lilbudek/vkr/отчет/tex-report/README.txt

В данной директории находятся последнии отчёты и заключительное слово студента (текст доклада).
