lilbudek/vkr/отчет/tex/chapter-appendix-csae.tex

\appendix
\newpage
\addcontentsline{toc}{chapter}{Приложение}
\begin{flushright}
\uppercase{Приложение}\label{appendix}
\end{flushright}
\begin{code}
\captionof*{listing}{Программа генератора сигналов.}
\begin{minted}[mathescape,linenos,frame=lines,breaklines]{text}
#include <stdio.h>
#include <wchar.h>
#include <libopencm3/stm32/rcc.h>
#include <libopencm3/stm32/flash.h>
#include <libopencm3/stm32/gpio.h>
#include <libopencm3/stm32/timer.h>
#include <libopencm3/cm3/nvic.h>
#include <libopencm3/stm32/dac.h>
#include <libopencm3/stm32/i2c.h>
#include <ssd1306_i2c.h>

static void gpio_setup(void);   // установить входы/выходы
static void dac_setup(void);    // настройка цап
static void i2c_setup(void);    // настройка и2ц
static void timers_setup(void); // настройка таймеров
static void nvic_setup(void);   // настройка прерываний
void minus_freq(void);          //
void plus_freq(void);           //
void minus_signal(void);        // функции для кнопок
void plus_signal(void);         //
void step_select(void);         //

uint16_t p_acc = 0;         // аккумулятор фазы
int p_step = 0;             // код частоты 192 - 1khz
uint16_t step = 0;          // размер шага
uint16_t signal[256] = {0}; // буфер для цапа
int8_t num_sig = 0;         // номер сигнала
int8_t num_step = 0;        // номер шага

/*  отсчеты сигналов    */
uint16_t sinus[256] = {2048, 2092, 2136, 2180, 2224, 2268, 2312, 2355, 2399, 2442,
                       2485, 2527, 2570, 2612, 2654, 2695, 2736, 2777, 2817, 2857, 2896, 2934, 2973, 3010, 3047,
                       3084, 3119, 3155, 3189, 3223, 3256, 3288, 3320, 3351, 3381, 3410, 3439, 3466, 3493, 3519,
                       3544, 3568, 3591, 3613, 3635, 3655, 3674, 3693, 3710, 3726, 3742, 3756, 3770, 3782, 3793,
                       3803, 3812, 3821, 3828, 3833, 3838, 3842, 3845, 3846, 3847, 3846, 3845, 3842, 3838, 3833,
                       3828, 3821, 3812, 3803, 3793, 3782, 3770, 3756, 3742, 3726, 3710, 3693, 3674, 3655, 3635,
                       3613, 3591, 3568, 3544, 3519, 3493, 3466, 3439, 3410, 3381, 3351, 3320, 3288, 3256, 3223,
                       3189, 3155, 3119, 3084, 3047, 3010, 2973, 2934, 2896, 2857, 2817, 2777, 2736, 2695, 2654,
                       2612, 2570, 2527, 2485, 2442, 2399, 2355, 2312, 2268, 2224, 2180, 2136, 2092, 2048, 2003,
                       1959, 1915, 1871, 1827, 1783, 1740, 1696, 1653, 1610, 1568, 1525, 1483, 1441, 1400, 1359,
                       1318, 1278, 1238, 1199, 1161, 1122, 1085, 1048, 1011, 976, 940, 906, 872, 839, 807, 775,
                       744, 714, 685, 656, 629, 602, 576, 551, 527, 504, 482, 460, 440, 421, 402, 385, 369, 353,
                       339, 325, 313, 302, 292, 283, 274, 267, 262, 257, 253, 250, 249, 248, 249, 250, 253, 257,
                       262, 267, 274, 283, 292, 302, 313, 325, 339, 353, 369, 385, 402, 421, 440, 460, 482, 504,
                       527, 551, 576, 602, 629, 656, 685, 714, 744, 775, 807, 839, 872, 906, 940, 976, 1011, 1048,
                       1085, 1122, 1161, 1199, 1238, 1278, 1318, 1359, 1400, 1441, 1483, 1525, 1568, 1610, 1653,
                       1696, 1740, 1783, 1827, 1871, 1915, 1959, 2003};
/*                      */
uint16_t square[256] = {3847, 3847, 3847, 3847, 3847, 3847, 3847, 3847, 3847, 3847,
                        3847, 3847, 3847, 3847, 3847, 3847, 3847, 3847, 3847, 3847, 3847, 3847, 3847, 3847,
                        3847, 3847, 3847, 3847, 3847, 3847, 3847, 3847, 3847, 3847, 3847, 3847, 3847, 3847,
                        3847, 3847, 3847, 3847, 3847, 3847, 3847, 3847, 3847, 3847, 3847, 3847, 3847, 3847,
                        3847, 3847, 3847, 3847, 3847, 3847, 3847, 3847, 3847, 3847, 3847, 3847, 3847, 3847,
                        3847, 3847, 3847, 3847, 3847, 3847, 3847, 3847, 3847, 3847, 3847, 3847, 3847, 3847,
                        3847, 3847, 3847, 3847, 3847, 3847, 3847, 3847, 3847, 3847, 3847, 3847, 3847, 3847,
                        3847, 3847, 3847, 3847, 3847, 3847, 3847, 3847, 3847, 3847, 3847, 3847, 3847, 3847,
                        3847, 3847, 3847, 3847, 3847, 3847, 3847, 3847, 3847, 3847, 3847, 3847, 3847, 3847,
                        3847, 3847, 3847, 3847, 3847, 3847, 248, 248, 248, 248, 248, 248, 248, 248, 248, 248,
                        248, 248, 248, 248, 248, 248, 248, 248, 248, 248, 248, 248, 248, 248, 248, 248, 248,
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
}

int main(void)
{
    rcc_clock_setup_in_hse_8mhz_out_72mhz(); // установка тактирования
    gpio_setup();
    nvic_setup();
    dac_setup();
    timers_setup();
    i2c_setup();
    ssd1306_init(I2C2, DEFAULT_7bit_OLED_SLAVE_ADDRESS, 128, 64); // инициализация дисплея

    int f = 0;       // переменная частоты
    wchar_t freq[8]; // буфер для wchar_t строки
    while (1)
    {
        f = p_step / 24 * 125;
        swprintf(freq, sizeof(freq) / sizeof(wchar_t), L"%d", f); // Использование swprintf для преобразования int в wchar_t*
        /*  вывод информации на дисплей  */
        ssd1306_clear();
        ssd1306_drawWCharStr(0, 0, white, nowrap, L"Форма сигнала:");
        switch (num_sig)
        {
        case 1:
            ssd1306_drawWCharStr(0, 8, white, nowrap, L"Синус");
            break;
        case 2:
            ssd1306_drawWCharStr(0, 8, white, nowrap, L"Меандр");
            break;
        case 3:
            ssd1306_drawWCharStr(0, 8, white, nowrap, L"Треугольник");
            break;
        case 4:
            ssd1306_drawWCharStr(0, 8, white, nowrap, L"Пила Левая");
            break;
        case 5:
            ssd1306_drawWCharStr(0, 8, white, nowrap, L"Пила Правая");
            break;
        }
        ssd1306_drawWCharStr(0, 16, white, nowrap, L"Частота(Гц)");
        ssd1306_drawWCharStr(64, 16, white, nowrap, freq);
        ssd1306_drawWCharStr(0, 32, white, nowrap, L"Шаг(Гц)");
        switch (num_step)
        {
        case 1:
            ssd1306_drawWCharStr(64, 32, white, nowrap, L"125");
            break;
        case 2:
            ssd1306_drawWCharStr(64, 32, white, nowrap, L"250");
            break;
        case 3:
            ssd1306_drawWCharStr(64, 32, white, nowrap, L"500");
            break;
        case 4:
            ssd1306_drawWCharStr(64, 32, white, nowrap, L"1000");
            break;
        }
        ssd1306_refresh();
    }

    return 0;
}

static void gpio_setup(void)
{
    // rcc_periph_clock_enable(RCC_GPIOD); // тактирование портов
    rcc_periph_clock_enable(RCC_GPIOB);
    gpio_set_mode(GPIOB, GPIO_MODE_INPUT, GPIO_CNF_INPUT_PULL_UPDOWN, GPIO9 | GPIO5 | GPIO6 | GPIO7 | GPIO8); // входы для кнопок, подтянуты к земле
    // gpio_set_mode(GPIOD, GPIO_MODE_OUTPUT_50_MHZ, GPIO_CNF_OUTPUT_PUSHPULL, GPIO2);
}

static void dac_setup(void)
{
    rcc_periph_clock_enable(RCC_GPIOA);
    gpio_set_mode(GPIOA, GPIO_MODE_OUTPUT_2_MHZ, GPIO_CNF_OUTPUT_ALTFN_PUSHPULL, GPIO5);
    rcc_periph_clock_enable(RCC_DAC); // тактирование цапа и настройка вывода
    dac_enable(CHANNEL_2);            // включить цап
}

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

static void timers_setup(void)
{
    rcc_periph_clock_enable(RCC_TIM2);
    rcc_periph_clock_enable(RCC_TIM3);

    /* Стартовое значение таймера */
    TIM_CNT(TIM2) = 0;
    TIM_CNT(TIM3) = 0;

    /* Предделитель 36MHz/36000 => 1000 отсчетов в секунду (счет начинается с 0, поэтому в предделителе и периоде нужно отнимать единичку) */
    TIM_PSC(TIM2) = 17;
    TIM_PSC(TIM3) = 35999;

    /* Период таймера */
    TIM_ARR(TIM2) = 9;
    TIM_ARR(TIM3) = 249;

    /* Включить прерывания */
    TIM_DIER(TIM2) |= TIM_DIER_UIE;
    TIM_DIER(TIM3) |= TIM_DIER_UIE;

    /* Запустить таймер */
    TIM_CR1(TIM2) |= TIM_CR1_CEN;
    TIM_CR1(TIM3) |= TIM_CR1_CEN;
}

static void nvic_setup(void)
{
    /* Активировать прерывания и установить приоритеты */
    nvic_enable_irq(NVIC_TIM2_IRQ);
    nvic_set_priority(NVIC_TIM2_IRQ, 2);

    nvic_enable_irq(NVIC_TIM3_IRQ);
    nvic_set_priority(NVIC_TIM3_IRQ, 1);
}

void minus_freq(void)
{
    bool cur_val = 0;
    bool prev_val = 0;
    cur_val = gpio_get(GPIOB, GPIO5);
    if (cur_val == 1 && prev_val == 0)
    {
        p_step -= step;
    }
    if (p_step < 0) // ограничение 0
    {
        p_step = 0;
    }
    prev_val = cur_val;
}

void plus_freq(void)
{
    bool cur_val = 0;
    bool prev_val = 0;
    cur_val = gpio_get(GPIOB, GPIO6);
    if (cur_val == 1 && prev_val == 0)
    {
        p_step += step;
    }
    if (p_step > 9600) // ограничение 50 кГц
    {
        p_step = 9600;
    }
    prev_val = cur_val;
}

void minus_signal(void)
{
    bool cur_val = 0;
    bool prev_val = 0;
    cur_val = gpio_get(GPIOB, GPIO7);
    if (cur_val == 1 && prev_val == 0)
    {
        dac_disable(CHANNEL_2);
        num_sig -= 1;
        if (num_sig < 1)
            num_sig = 1;
        switch (num_sig)
        {
        case 1:
            for (int i = 0; i < 256; i++)
                signal[i] = sinus[i];
            break;
        case 2:
            for (int i = 0; i < 256; i++)
                signal[i] = square[i];
            break;
        case 3:
            for (int i = 0; i < 256; i++)
                signal[i] = triangle[i];
            break;
        case 4:
            for (int i = 0; i < 256; i++)
                signal[i] = l_saw[i];
            break;
        case 5:
            for (int i = 0; i < 256; i++)
                signal[i] = r_saw[i];
            break;
        }
        dac_enable(CHANNEL_2);
    }
    prev_val = cur_val;
}

void plus_signal(void)
{
    bool cur_val = 0;
    bool prev_val = 0;
    cur_val = gpio_get(GPIOB, GPIO8);
    if (cur_val == 1 && prev_val == 0)
    {
        dac_disable(CHANNEL_2);
        num_sig += 1;
        switch (num_sig)
        {
        case 1:
            for (int i = 0; i < 256; i++)
                signal[i] = sinus[i];
            break;
        case 2:
            for (int i = 0; i < 256; i++)
                signal[i] = square[i];
            break;
        case 3:
            for (int i = 0; i < 256; i++)
                signal[i] = triangle[i];
            break;
        case 4:
            for (int i = 0; i < 256; i++)
                signal[i] = l_saw[i];
            break;
        case 5:
            for (int i = 0; i < 256; i++)
                signal[i] = r_saw[i];
            break;
        }
        if (num_sig > 5)
            num_sig = 5;
        dac_enable(CHANNEL_2);
    }
    prev_val = cur_val;
}

void step_select(void)
{
    bool cur_val = 0;
    bool prev_val = 0;
    cur_val = gpio_get(GPIOB, GPIO9);
    if (cur_val == 1 && prev_val == 0)
    {
        num_step += 1;
        switch (num_step)
        {
        case 1:
            step = 24; // 125 Гц
            break;
        case 2:
            step = 48; // 250 Гц
            break;
        case 3:
            step = 96; // 500 Гц
            break;
        case 4:
            step = 192; // 1000 Гц
            break;
        case 5:
            step = 24; // 125 Гц
            num_step = 1;
            break;
        }
    }
}
\end{minted}
\end{code}

% Проверить работу в содержании, правильную нумерацию приложений и переброску по ссылки.
%\chapter*{Приложение A}
%\phantomsection
%\addcontentsline{toc}{chapter}{Приложение A}
%\label{appendixA}
