lilbudek/vkr/отчет/tex-presentation/pictures/struct_gen.pdf

Кнопки | Микроконтроллер

Дисплей

I2C

Выход ЦАП
