lilbudek/vkr/отчет/image/README.txt

В данной директории должны находится все рисунки, которые используются в ВКР.
