lilbudek/vkr/отчет/tex-presentation/README.txt

В данной директории должны находится файлы относящиеся к презентации.
