lilbudek/vkr/отчет/tex/README.txt

В данной директории находятся файлы ВКР, то есть основной работы.
