lilbudek/vkr/отчет/tex-presentation/pres.pdf

## Программный генератор сигналов на основе микроконтроллера STM32

Студент гр. 506: Вебер Данил Сергеевич Руководитель: ст.пр. Уланов Пётр Николаевич

Алтайский государственный университет

2024

## Актуальность

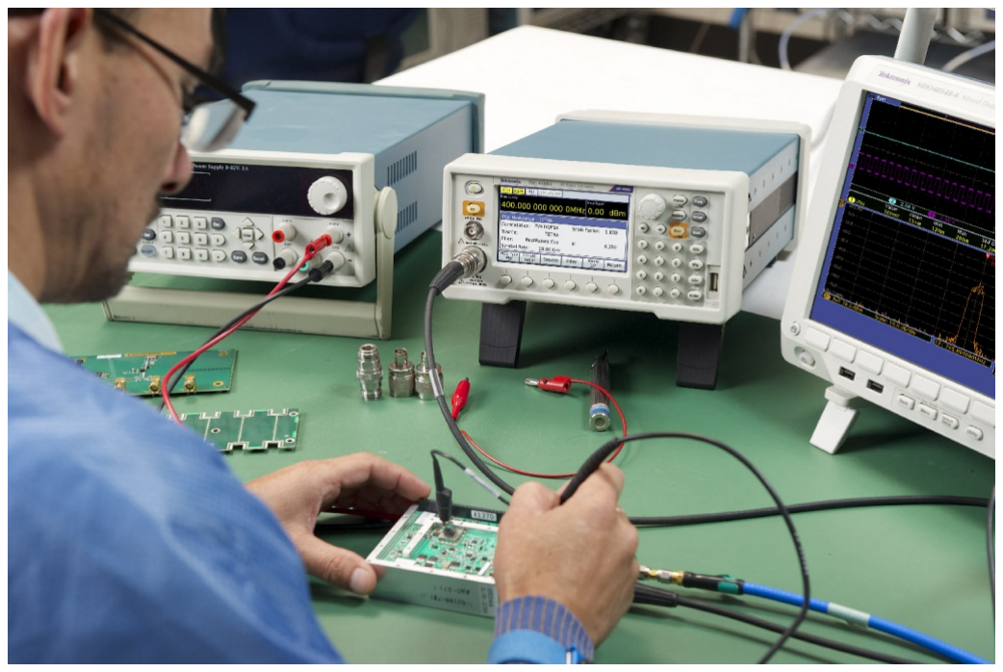
[picture p51: figure]

Тестирование и отладка устройства.

## Цель и задачи

Цель: разработка программного генератора сигналов на микроконтроллере.
Задачи:
1 | Исследовать методы генерации сигналов и осуществить выбор;
2 | Рассмотреть семейства микроконтроллеров и осуществить выбор;
3 | Выбрать среду разработки;
4 | Разработать программу;
5 | Спроектировать устройство;
6 | Протестировать генератор.

## Методы цифровой генерации сигнала

1 | Метод аппроксимации. +: Малый объем памяти, так как хранятся только параметры сигнала. —: Высокие вычислительные затраты, что ограничивает максимальную частоту сигнала.
2 | CORDIC. +: Быстродействие и высокая точность системы, благодаря итерационному методу. —: Сложность алгоритма и потребность в специализированных вычислениях.
3 | Табличный метод. +: Возможность генерации сигналов с более высокой частотой из-за отсутствия вычислений. —: Необходимость хранения больших объёмов данных в памяти.
4 | Метод DDS. +: Гибкость, простота реализации и высокая точность регулирования частоты. —: Потребность в дополнительных вычислениях для генерации сигнала.

## Метод DDS

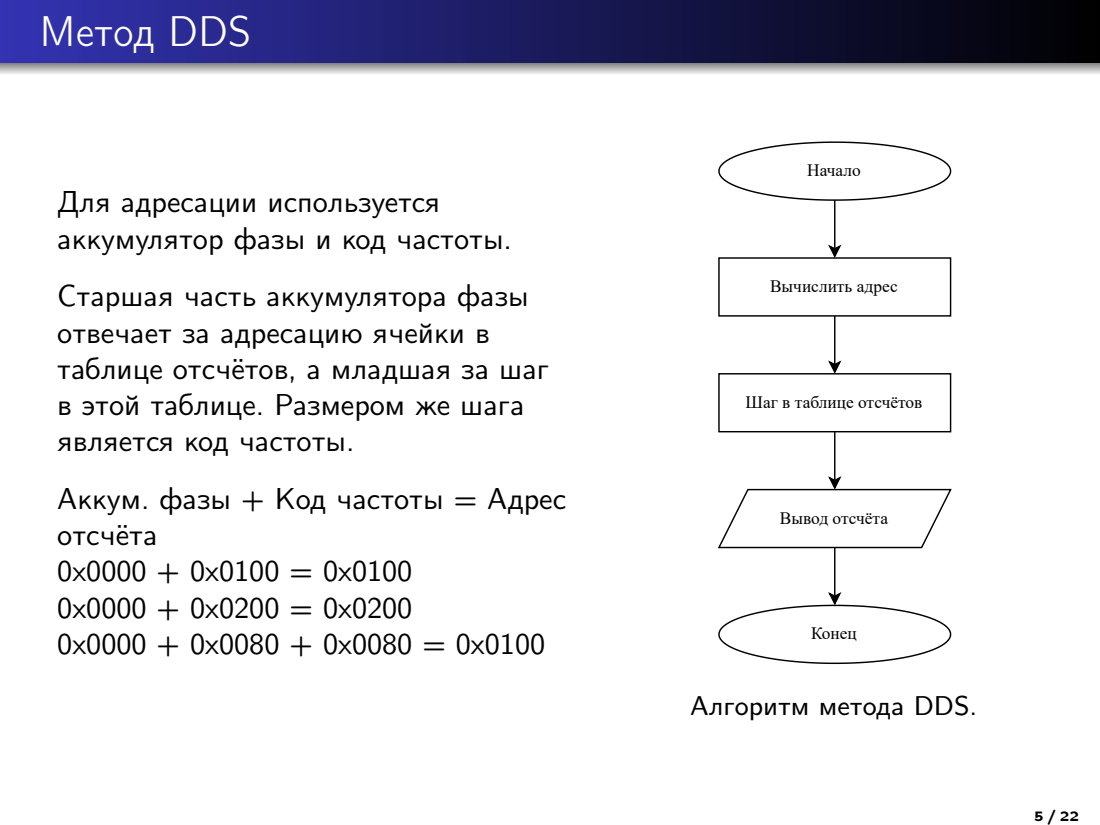
[picture p52: page 5]
Аккум. фазы + Код частоты = Адрес отсчёта 0x0000 + 0x0100 = 0x0100 0x0000 + 0x0200 = 0x0200 0x0000 + 0x0080 + 0x0080 = 0x0100; Начало; Вычислить адрес; Вывод отсчёта; Конец

Для адресации используется
аккумулятор фазы и код частоты.

Старшая часть аккумулятора фазы
отвечает за адресацию ячейки в
таблице отсчётов, а младшая за шаг
в этой таблице. Размером же шага
является код частоты.

Шаг в таблице отсчётов

Алгоритм метода DDS.

## Существующие генераторы

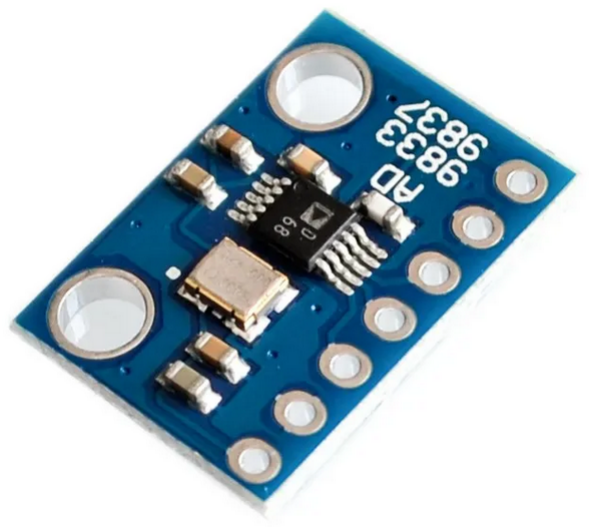
[picture p53: figure]

Модуль AD9833. | АКТАКОМ AWG-4112.

+: компактность, возможность
интеграции с другими
компонентами.
—: необходимость в управляющем устройстве.

+: высокая точность, широкий диапазон частот.
—: большие размеры, высокая стоимость.

## Микроконтроллеры

Параметры микроконтроллеров

Параметр | ATtiny10 | ATmega32 | STM32L010F4 | STM32F103xC
Частота | 20 МГц | 20 МГц | 32 МГц | 72 МГц
FLASH | 1 Кбайт | 32 Кбайт | 16 Кбайт | 256 Кбайт
RAM | 64 байт | 2 Кбайт | 2 Кбайт | 48 Кбайт
SPI | - | + | + | +
I2C | - | + | + | +
Питание | 1,8 — 5,5 В | 1,8 — 5,5 В | 1,8 — 3,6 В | 1,8 — 3,6 В

## Выбор микроконтроллера и среды разработки

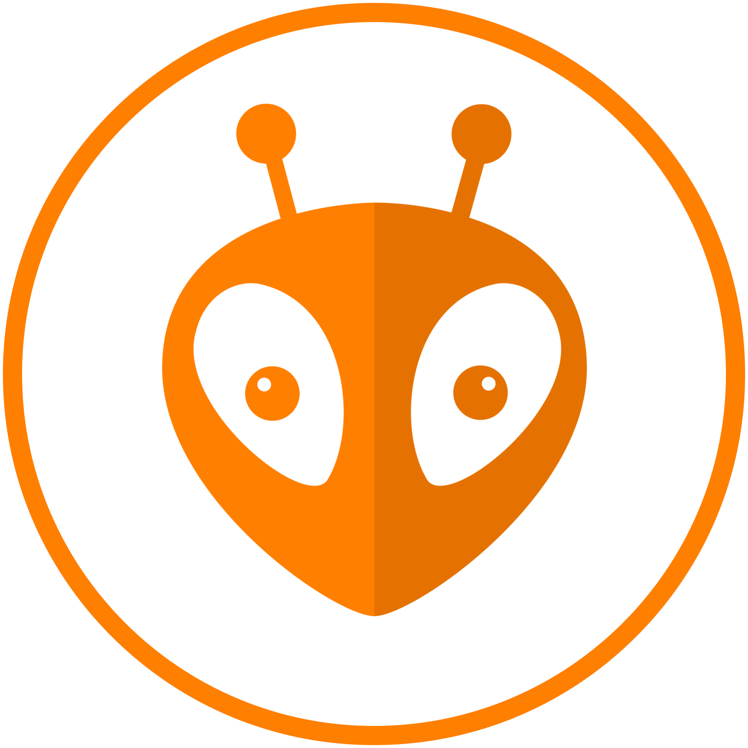
[picture p54: figure]
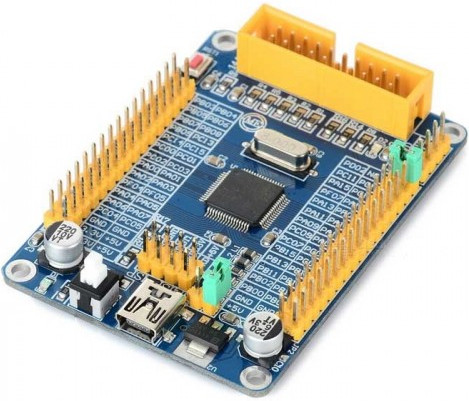
[picture p55: figure]

Микроконтроллер | IDE

Микроконтроллер: STM32F103RCT6 на отладочной плате. Среда разработки: VSCode + PlatformIO.
Язык программирования: C.
Библиотека: libopencm3.

## Программа для генерации сигналов

Кнопки | Микроконтроллер

Дисплей

I2C

Выход ЦАП

Структурная схема генератора сигналов.

Программа должна выполнять три действия:
1 | Вывод отсчёта в ЦАП;
2 | Обработка кнопок;
3 | Вывод информации на дисплей.

## Программа для генерации сигналов

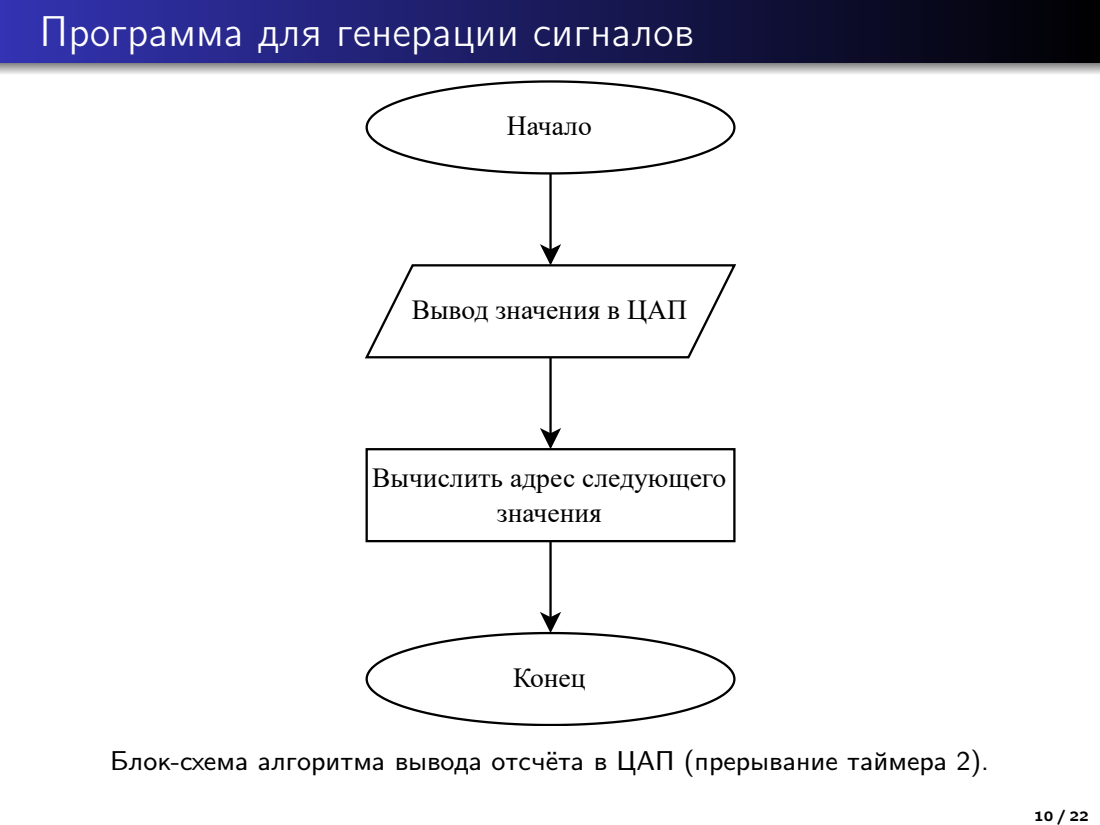
[picture p56: page 10]
Начало; значения; Конец

Вывод значения в ЦАП

Вычислить адрес следующего

Блок-схема алгоритма вывода отсчёта в ЦАП (прерывание таймера 2).

## Программа для генерации сигналов

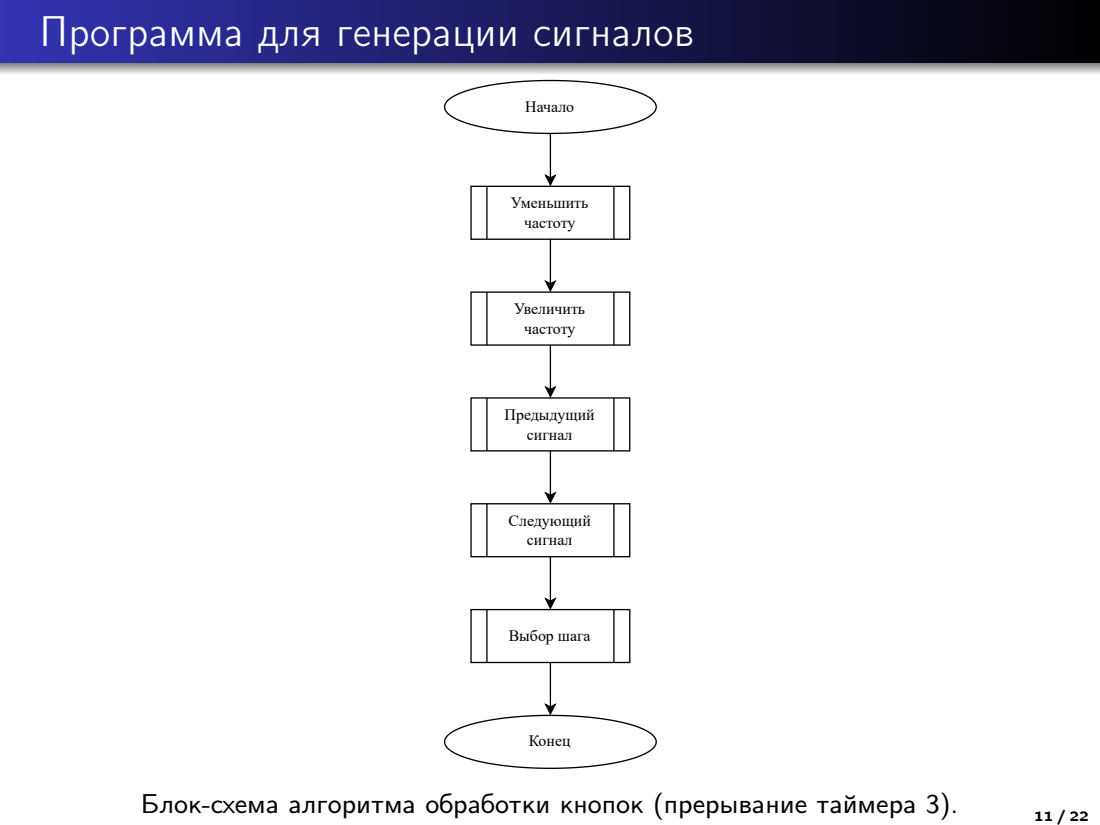
[picture p57: page 11]
Начало; Уменьшить частоту; Увеличить частоту; Предыдущий сигнал; Следующий сигнал; Выбор шага; Конец; Блок-схема алгоритма обработки кнопок (прерывание таймера 3).

## Программа для генерации сигналов

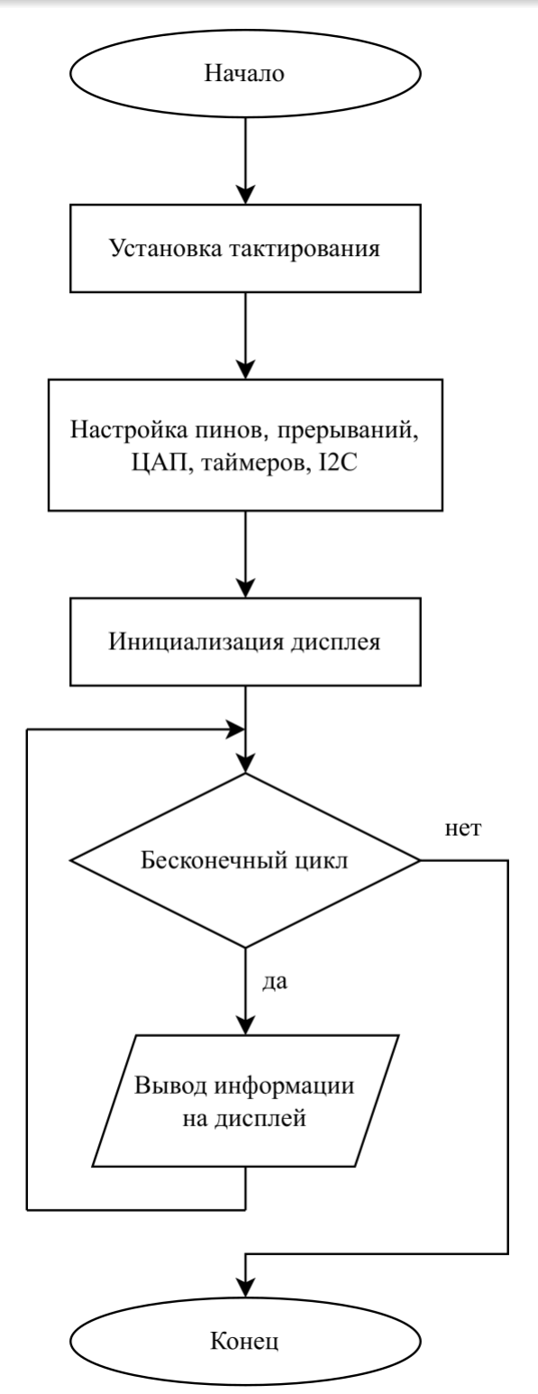
[picture p58: figure]

Блок-схема алгоритма главной функции. | 12 / 22

## Проектирование генератора сигналов

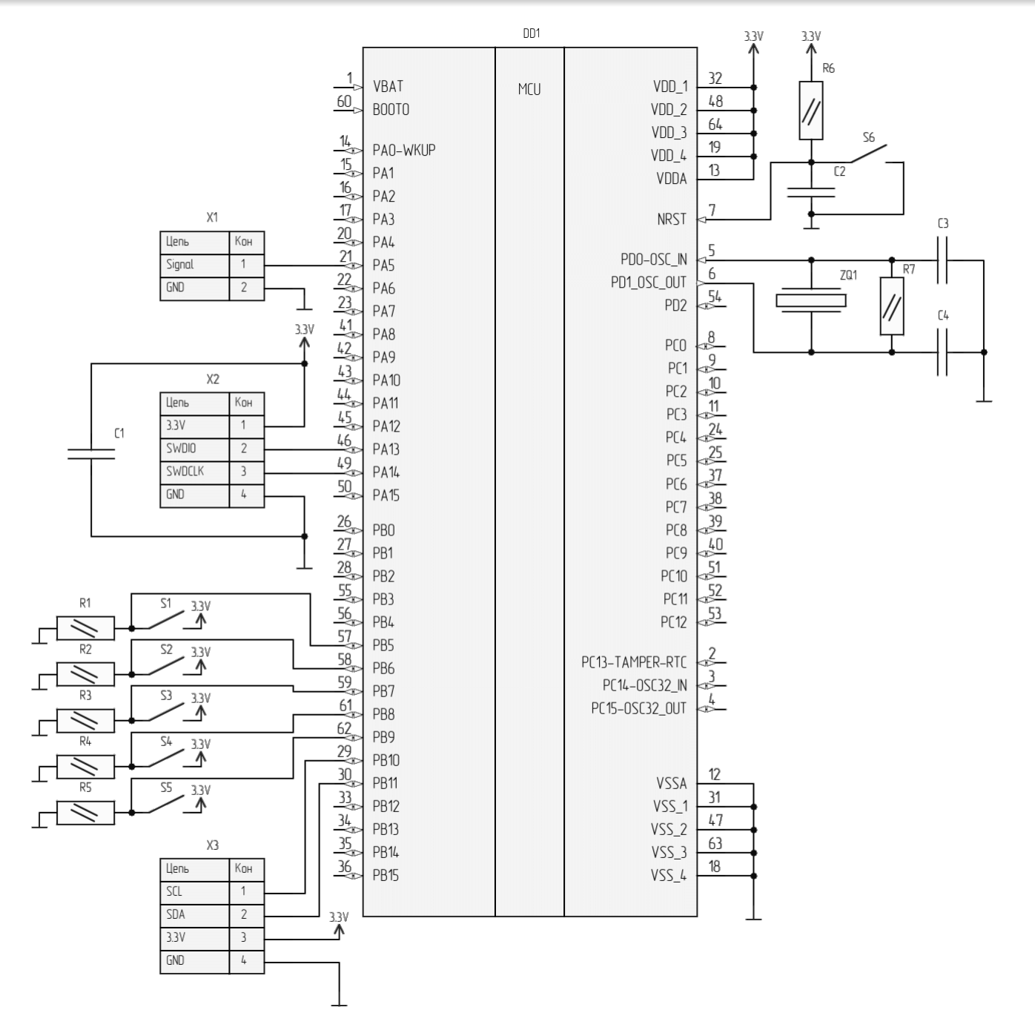
[picture p59: figure]

Фрагмент схемы электрической принципиальной. | 13 / 22

## Проектирование генератора сигналов

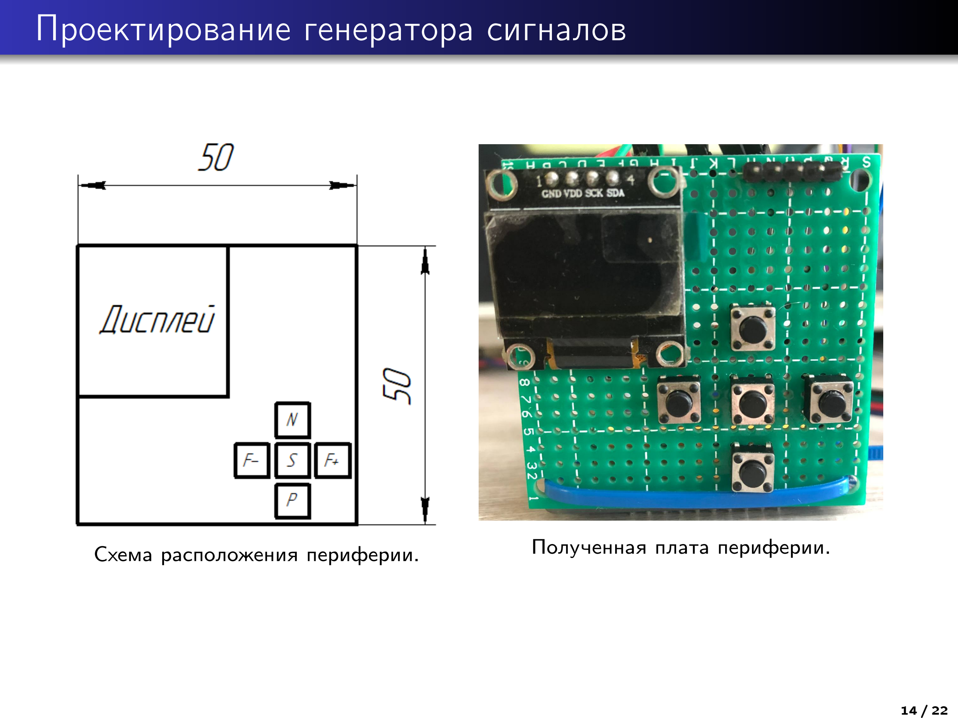
[picture p60: page 14]

Схема расположения периферии. | Полученная плата периферии.

## Проектирование генератора сигналов

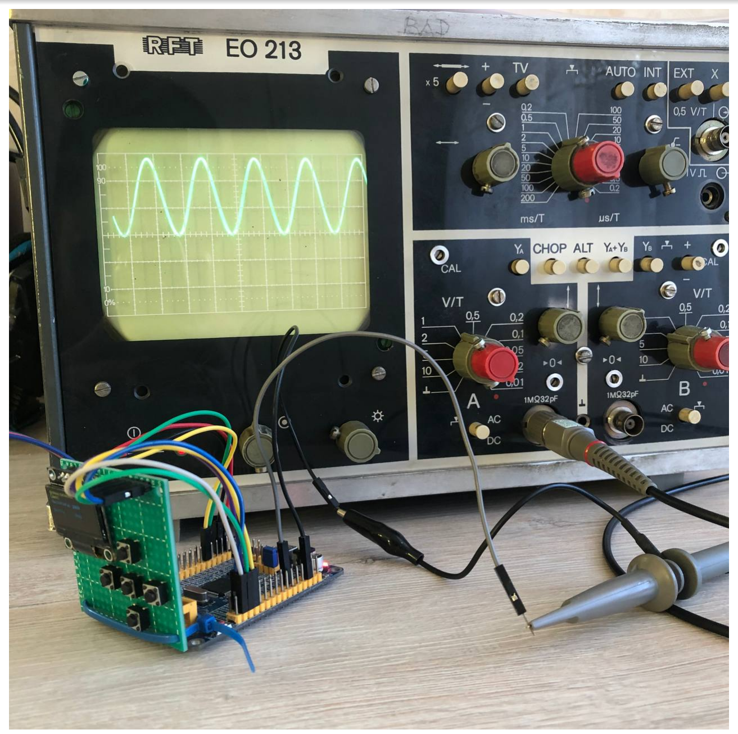
[picture p61: figure]

Макет устройства. | 15 / 22

## Тестирование

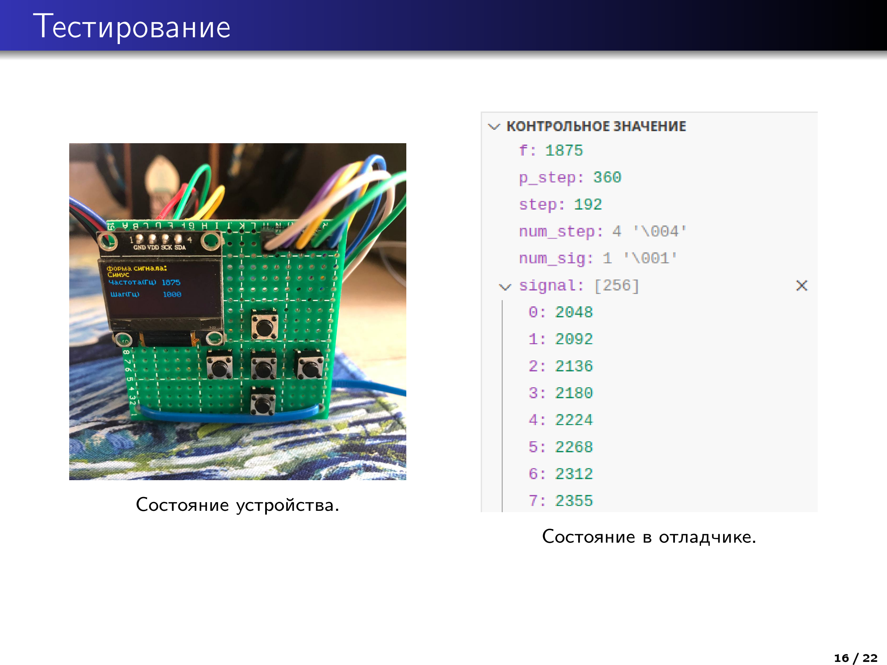
[picture p62: page 16]

Состояние устройства.

Состояние в отладчике.

## Тестирование

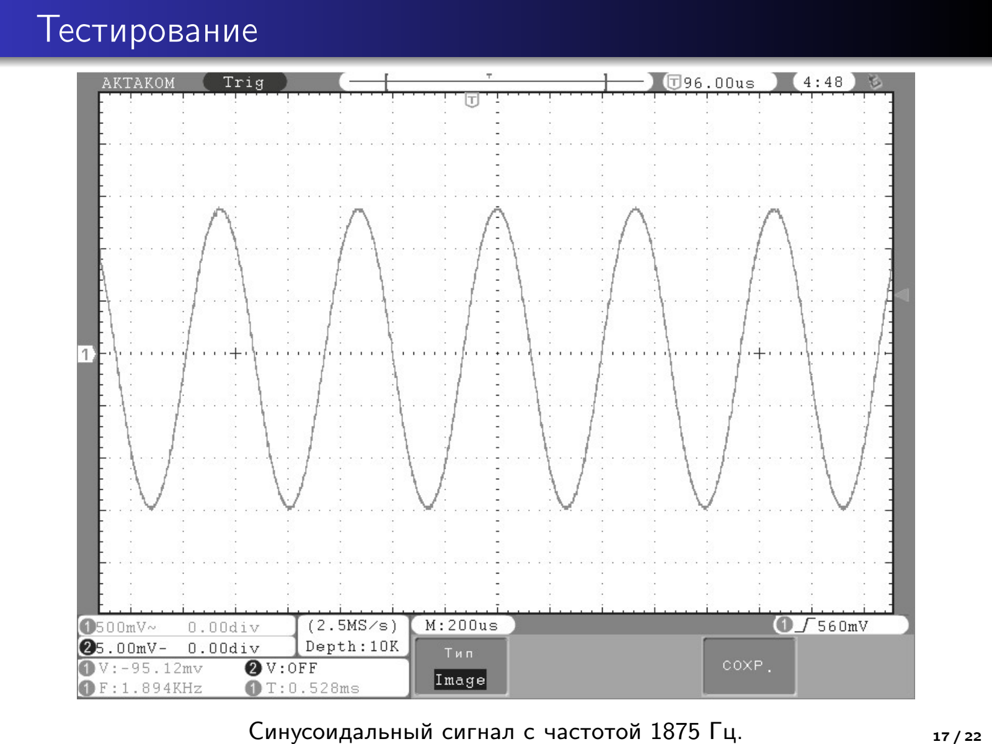
[picture p63: page 17]

Синусоидальный сигнал с частотой 1875 Гц. | 17 / 22

## Тестирование

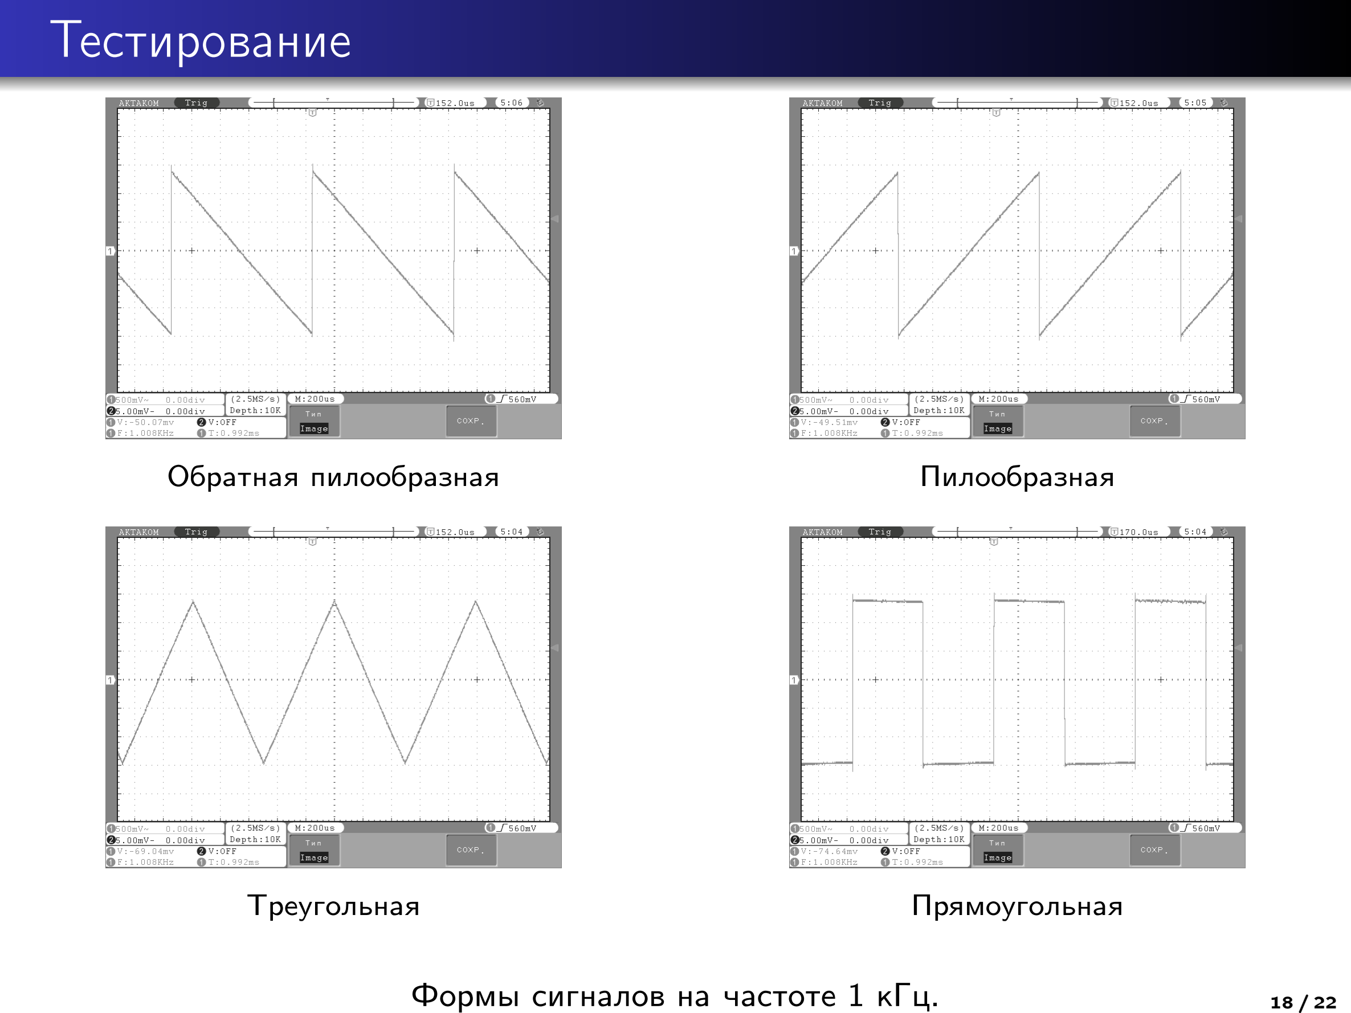
[picture p64: page 18]

Обратная пилообразная | Пилообразная
Треугольная | Прямоугольная
Формы сигналов на частоте 1 кГц. | 18 / 22

## Тестирование

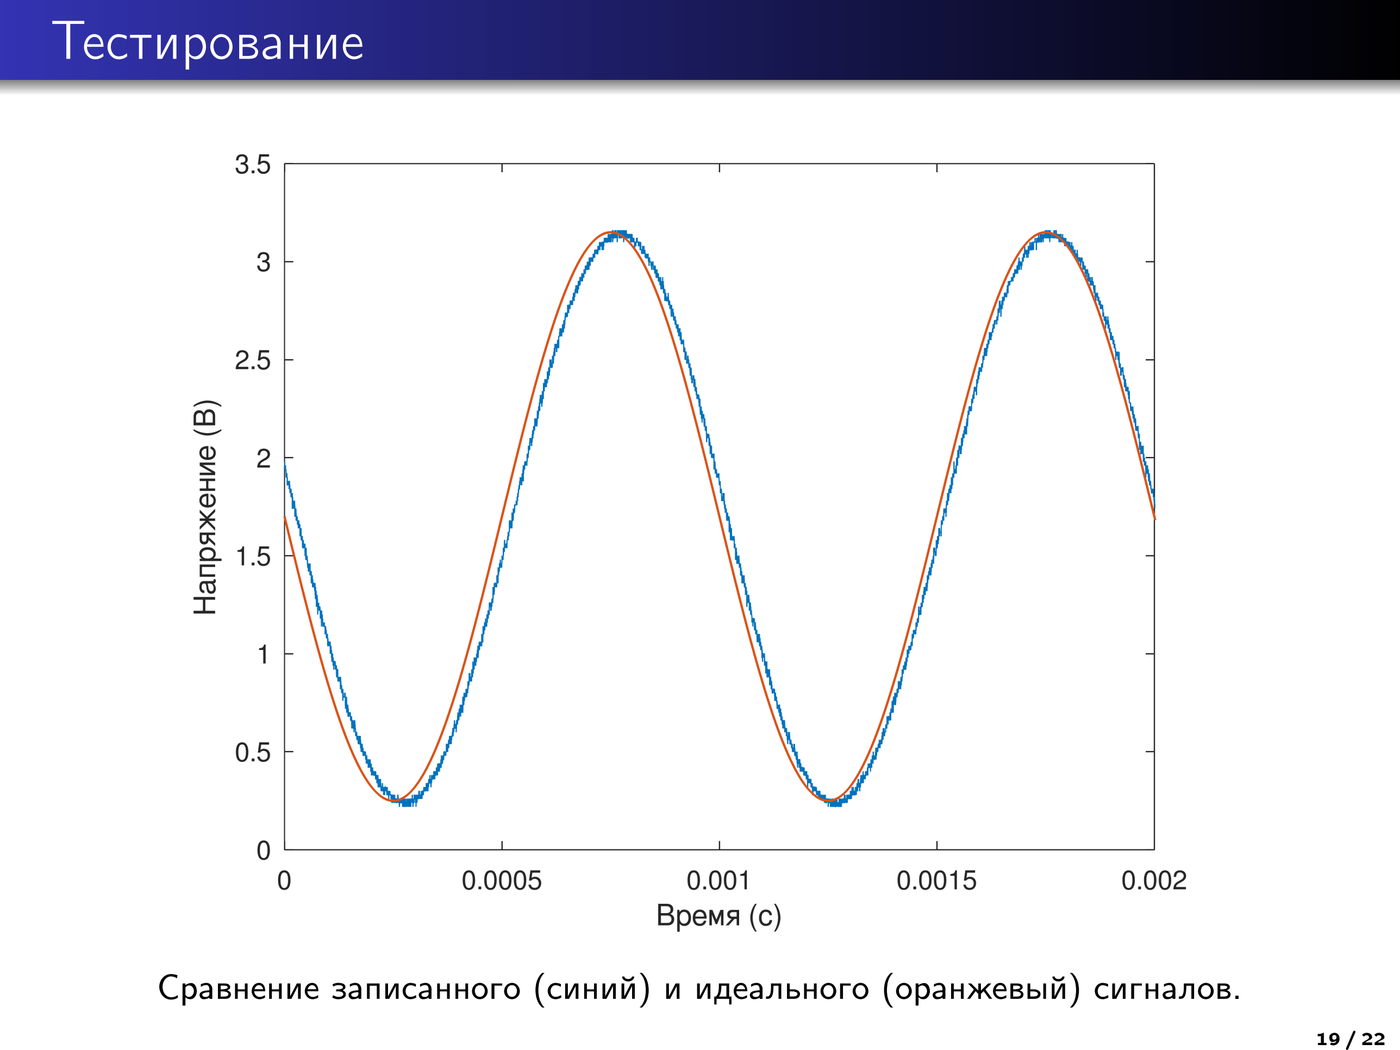
[picture p65: page 19]

Сравнение записанного (синий) и идеального (оранжевый) сигналов.

## Тестирование

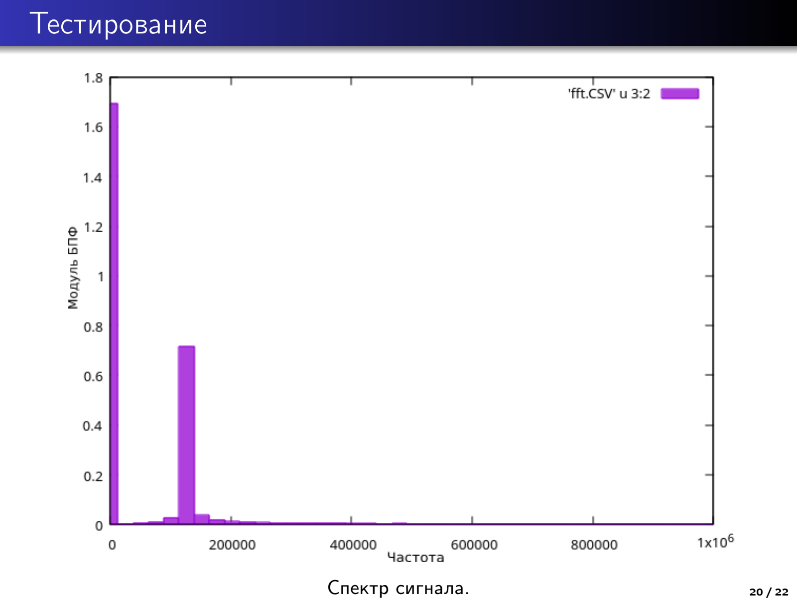
[picture p66: page 20]

Спектр сигнала. | 20 / 22

## Заключение

В ходе выполнения работы цель была достигнута: разработан программный генератор сигналов на микроконтроллере STM32F103RCT6, позволяющий генерировать сигналы разной формы со следующими характеристиками:
Формы сигналов: синус, треугольник, прямоугольник, пилообразная, обратная пилообразная.
Частота сигнала: 125 — 50000 Гц.
Шаг по частоте: 125, 250, 500, 1000 Гц.
Были выполнены все поставленные задачи, а именно:
1 | Выбран метод генерации сигналов;
2 | Выбран микроконтроллер;
3 | Выбрана среда разработки;
4 | Разработана программа;
5 | Спроектировано устройство;
6 | Протестирован генератор.

# Спасибо за внимание!
