lilbudek/vkr/отчет/image/scheme-cropped.pdf

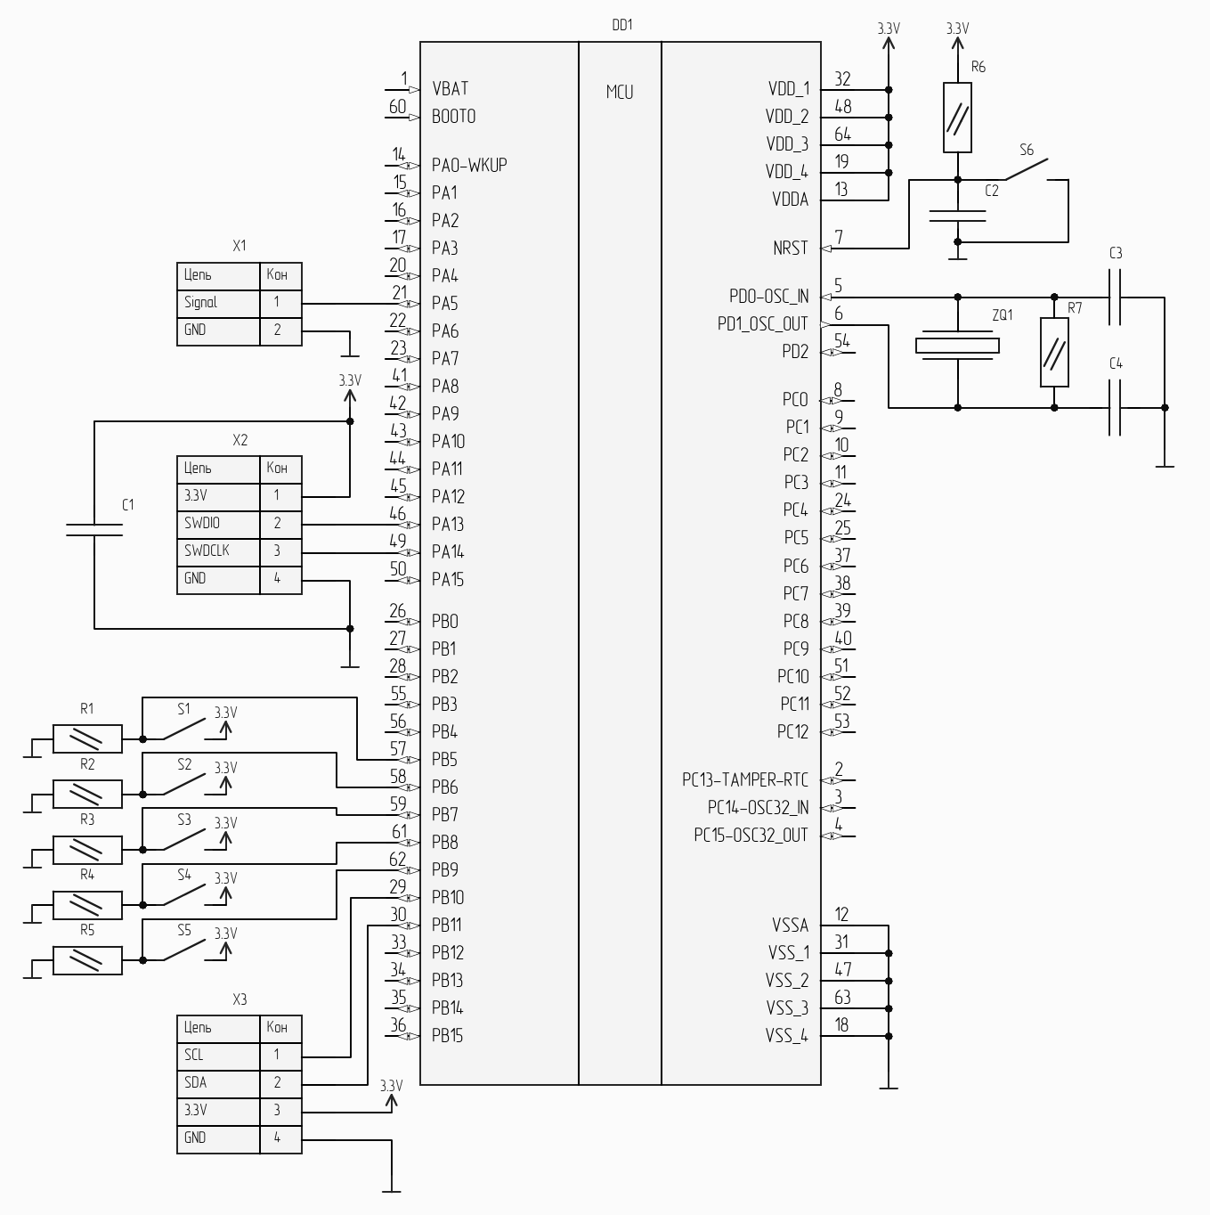
[picture p67: page 1]
