lilbudek/vkr/моя наука/pictures/qr-code.pdf

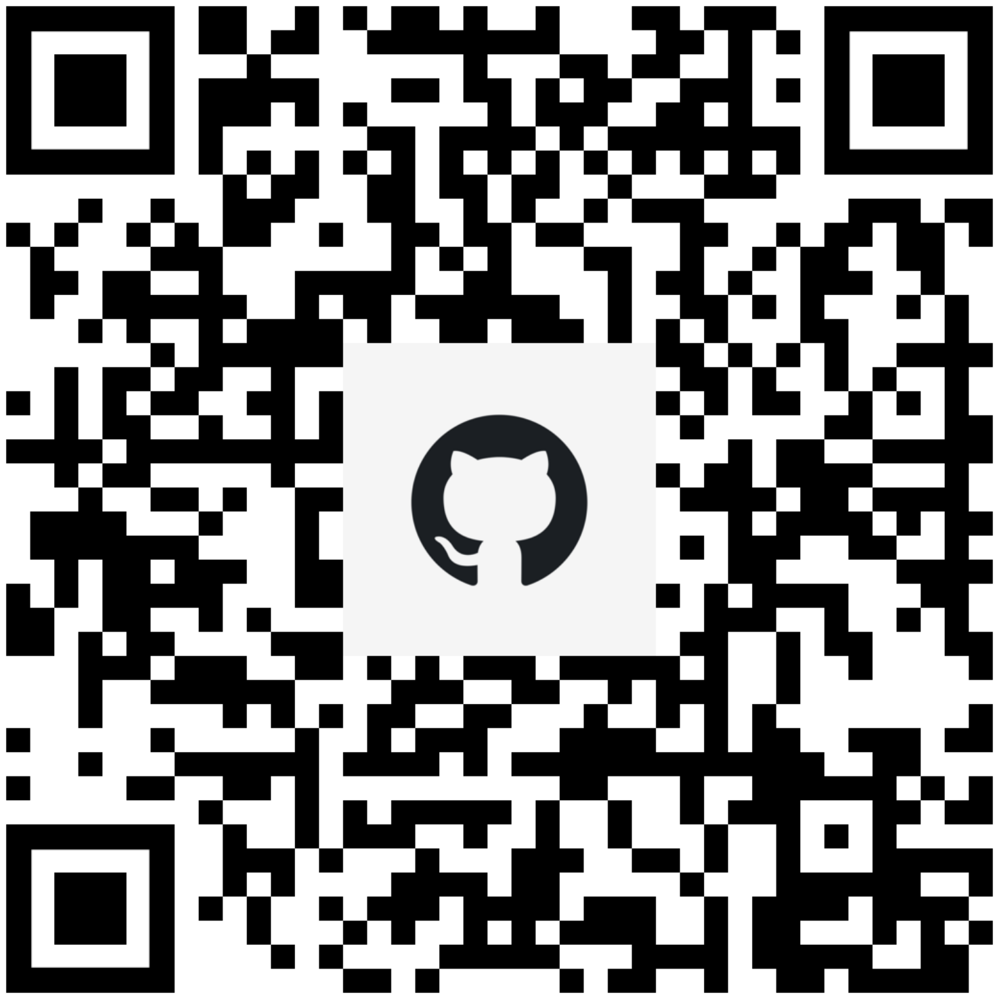
[picture p68: page 1]
