lilbudek/vkr/отчет/tex-presentation/pictures/main.pdf

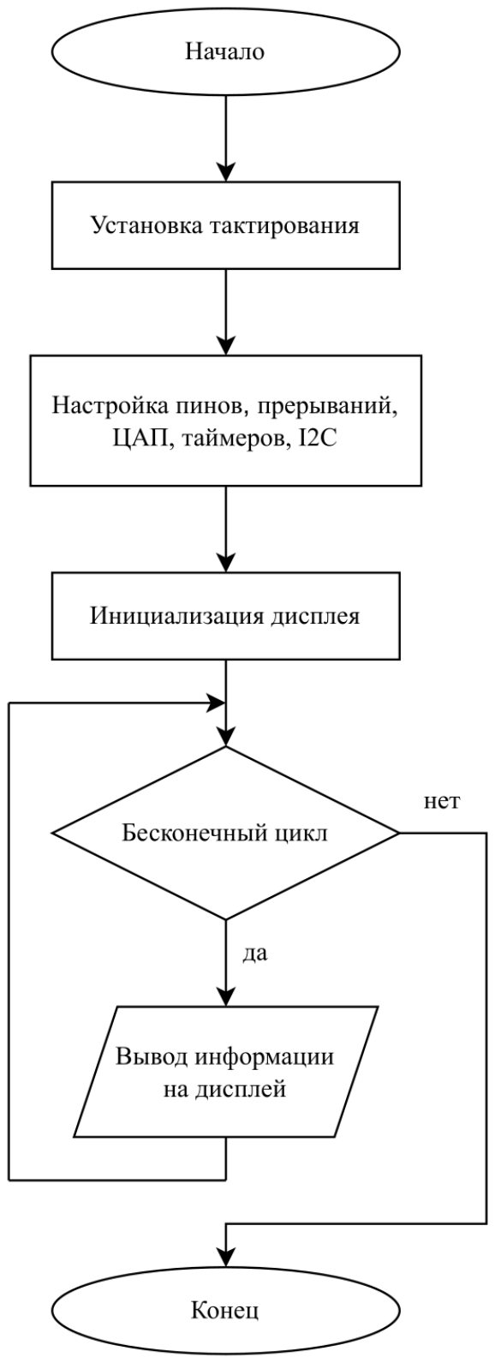
[picture p69: page 1]
