lilbudek/vkr/защита темы/pres.pdf

## Создание программного генератора сигналов

разной формы на микроконтроллере STM32.

Студент гр. 506: Вебер Д.С. Научный руководитель: ст.пр. Уланов П.Н.

Алтайский государственный университет

2023

## Цель и задачи

Цель работы: разработка программы для генерации сигналов на микроконтроллере STM32.
Задачи:
1 | Исследовать существующие способы программной генерации сигналов.
2 | Выбрать микроконтроллер для реализации.
3 | Выбрать среду разработки.
4 | Написать программу.
5 | Провести проверку работоспособности.

## Микроконтроллеры

МК Параметр | F103RCT6 | F302CBT6 | F373CCT6 | G431CBT6
Память программ | 256 Кбайт | 128 Кбайт | 256 Кбайт | 128 Кбайт
ОЗУ | 48 Кбайт | 32 Кбайт | 32 Кбайт | 32 Кбайт
Тактовая частота | 72 МГц | 72 МГц | 72 МГц | 170 МГц
Кол-во вх/вых | 51 | 37 | 36 | 38
ЦАП | 2х12б | 1х12б | 3х12б | 4х12б
