lilbudek/vkr/отчет/image/125.bmp

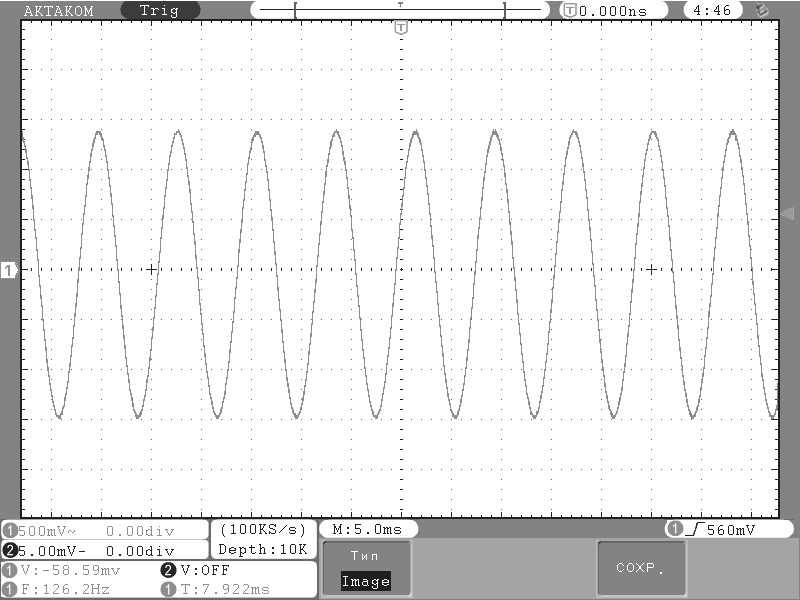
отчет/image/125.bmp
