lilbudek/vkr/отчет/image/875.bmp

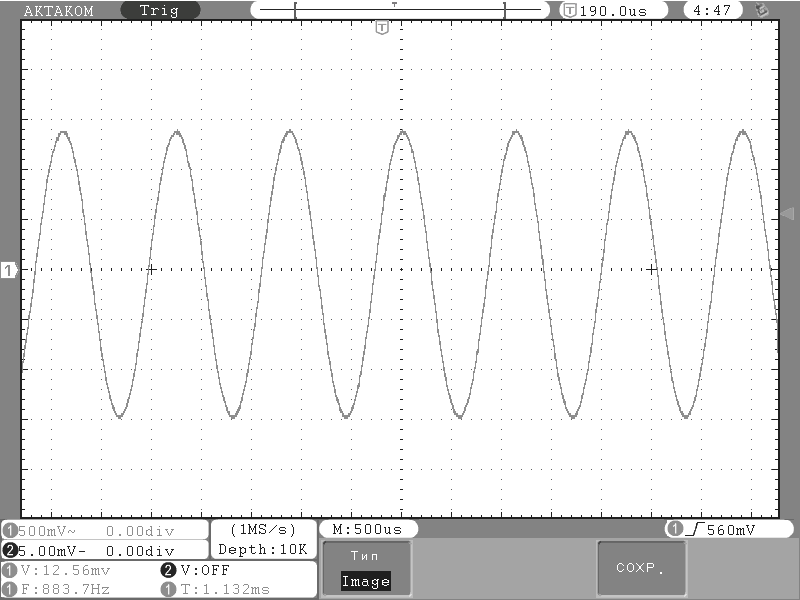
отчет/image/875.bmp
