lilbudek/vkr/отчет/image/l_saw10.bmp

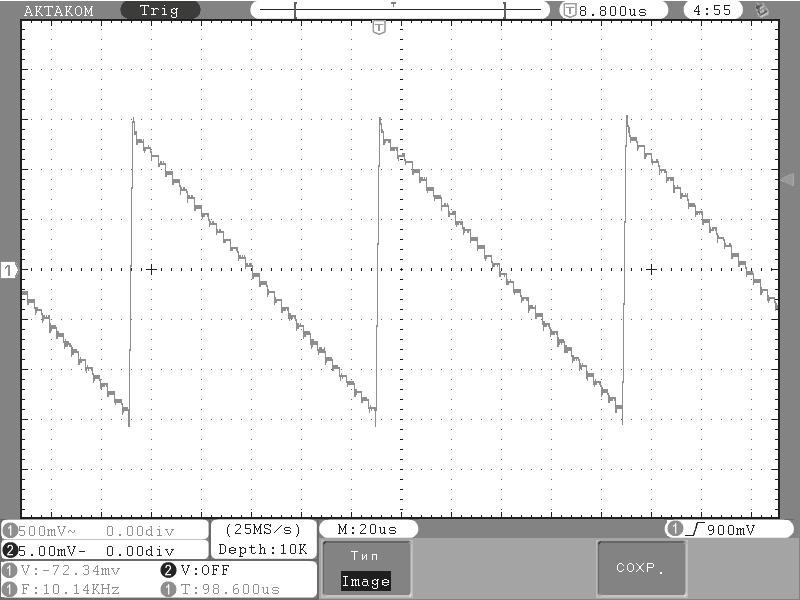
отчет/image/l_saw10.bmp
