lilbudek/vkr/отчет/image/r_saw10.bmp

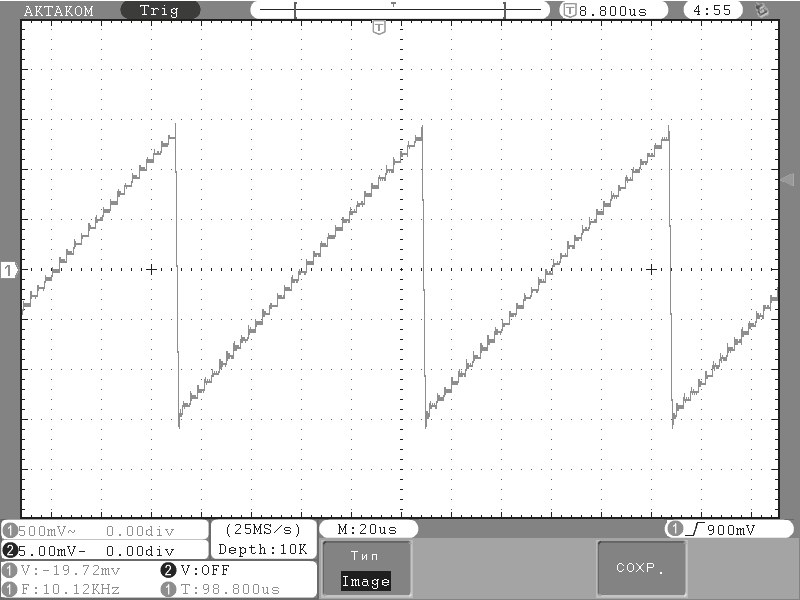
отчет/image/r_saw10.bmp
