lilbudek/vkr/отчет/image/s_noise.png

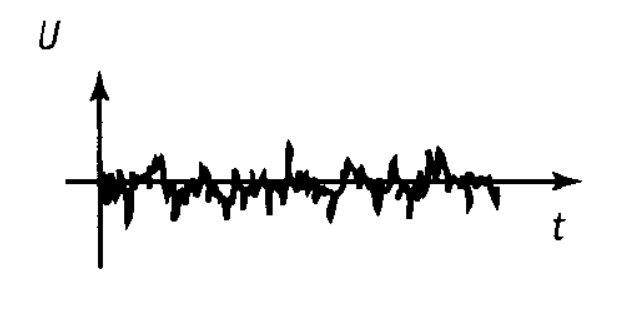
отчет/image/s_noise.png
