lilbudek/vkr/отчет/image/s_sp.png

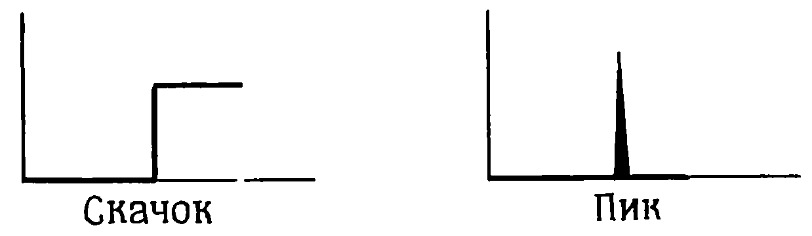
отчет/image/s_sp.png
