lilbudek/vkr/отчет/image/square10.bmp

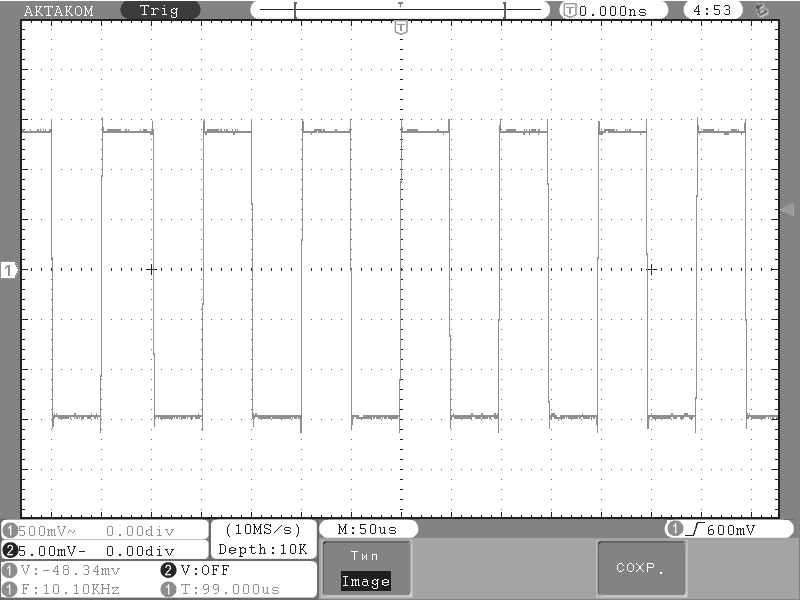
отчет/image/square10.bmp
