lilbudek/vkr/отчет/image/display.pdf

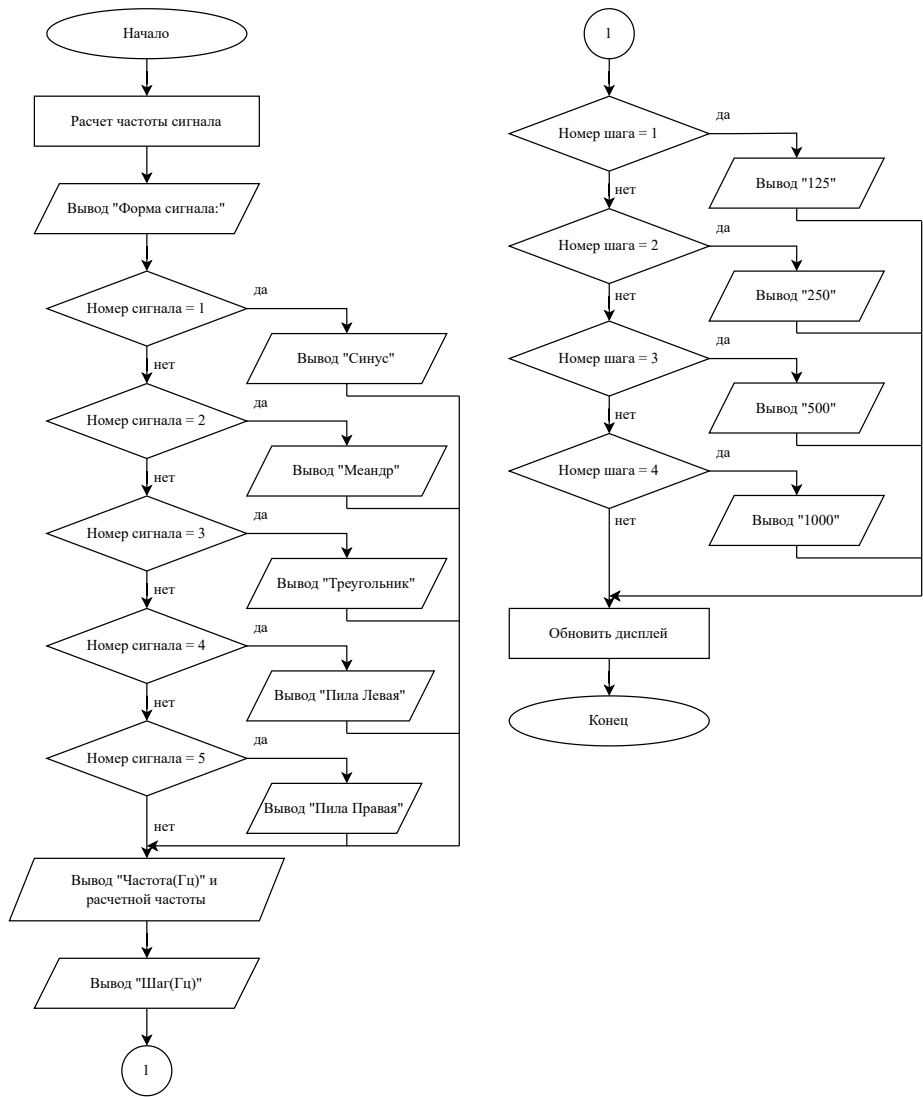
[picture p88: page 1]
Начало; Номер сигнала = 1; Номер сигнала = 2; Номер сигнала = 3; Номер сигнала = 4; Номер сигнала = 5; нет; Вывод "Синус"; Вывод "Меандр"; Вывод "Треугольник"; Номер шага = 1; Номер шага = 2; Номер шага = 3; Номер шага = 4; Вывод "125"; Вывод "250"; Вывод "500"; Вывод "1000"; Обновить дисплей; Конец

Расчет частоты сигнала

Вывод "Форма сигнала:"

Вывод "Пила Левая"

Вывод "Пила Правая"

Вывод "Частота(Гц)" и
расчетной частоты

Вывод "Шаг(Гц)"
