lilbudek/vkr/отчет/image/plus_signal.pdf

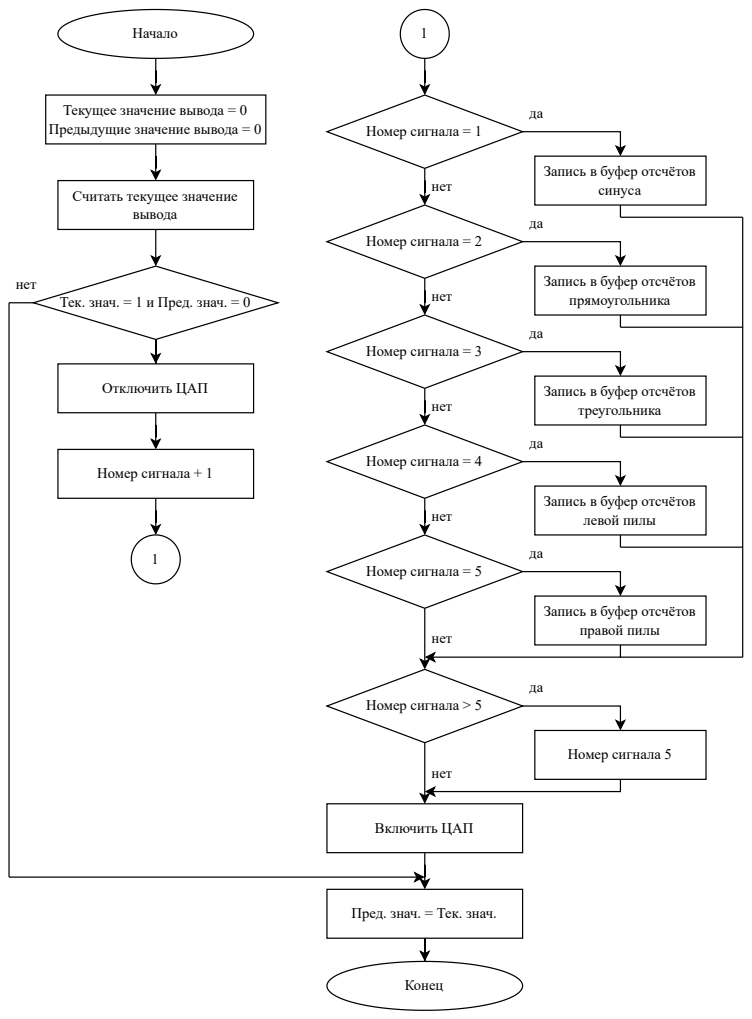
[picture p89: page 1]
Начало; вывода; Отключить ЦАП; Номер сигнала + 1; Номер сигнала = 1; Номер сигнала = 2; Номер сигнала = 3; Номер сигнала = 4; Номер сигнала = 5; Номер сигнала > 5; синуса; Номер сигнала 5; Включить ЦАП; Конец; нет

Текущее значение вывода = 0
Предыдущие значение вывода = 0

Запись в буфер отсчётов

Считать текущее значение

нет
Тек. знач. = 1 и Пред. знач. = 0

прямоугольника

треугольника

левой пилы

правой пилы

Пред. знач. = Тек. знач.
