lilbudek/vkr/altium/gen/scheme-cropped.pdf

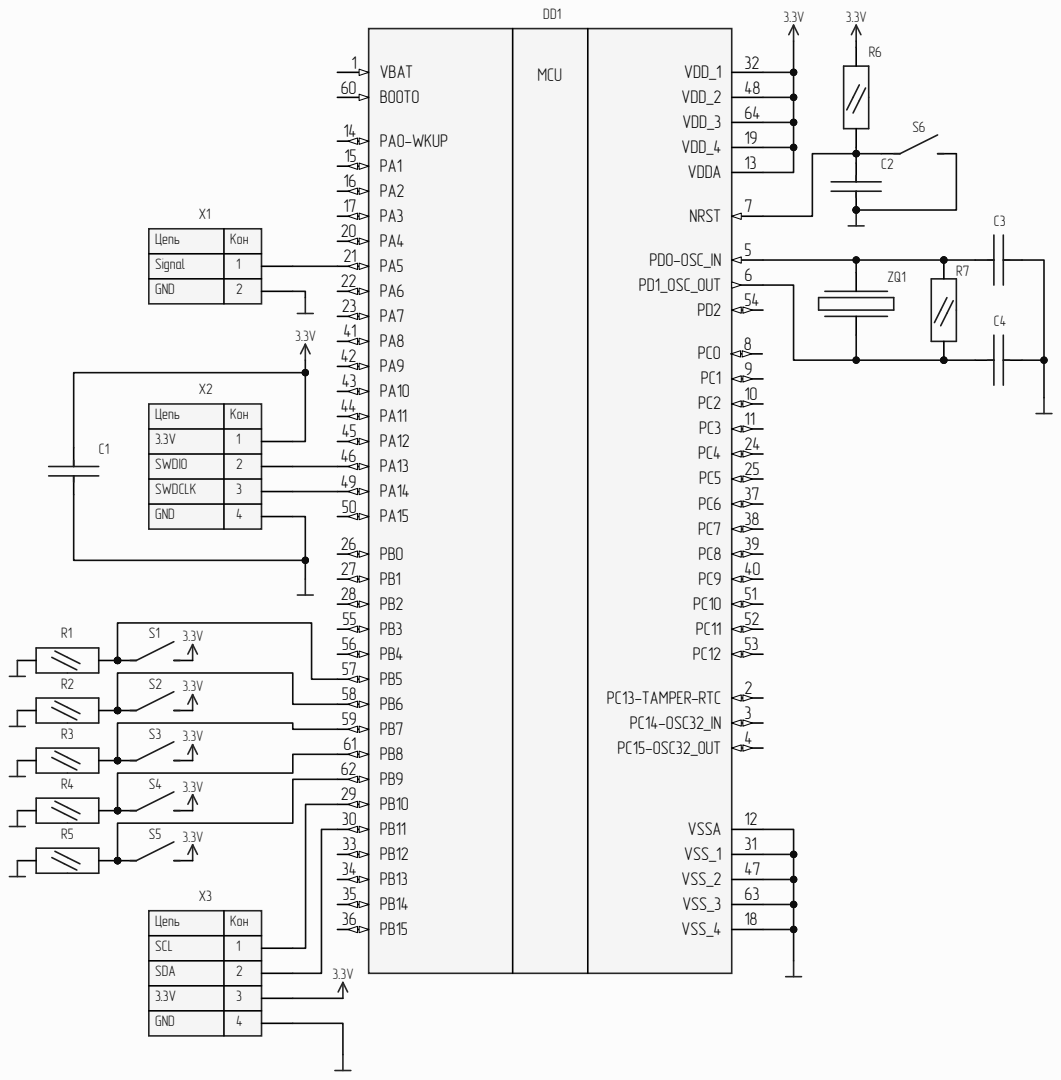
[picture p90: page 1]

A A Инв. № подл. Инв. № дубл. Подп. и дата Взам. инв. № Подп. и дата Перв. примен. Справ. №
