lilbudek/vkr/altium/gen/scheme.pdf

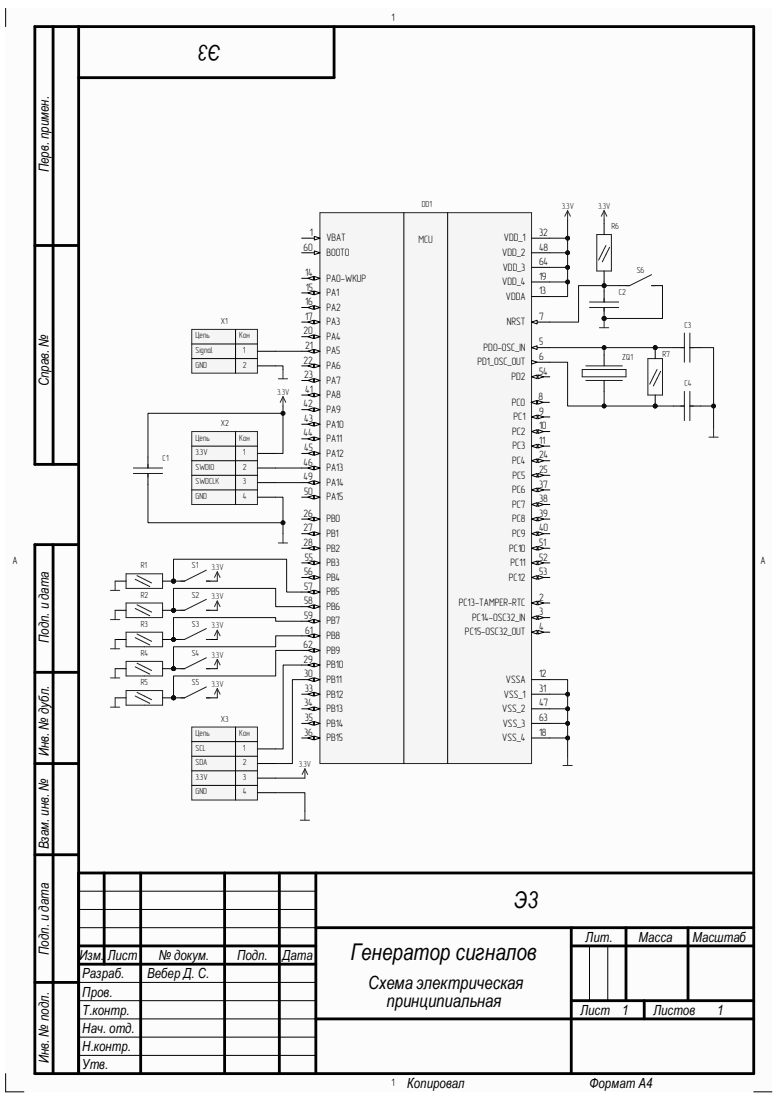
[picture p91: page 1]
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

Генератор сигналов Схема электрическая принципиальная | Лит. | Масса | Масштаб

Изм. | Лист | № докум. | Подп. | Дата
Разраб. | | Вебер Д. С.
Пров.
Т.контр. | | | | | Лист 1 | Листов 1
Нач. отд.
Н.контр.
Утв.
