lilbudek/vkr/отчет/tex-presentation/pictures/dds_block.pdf

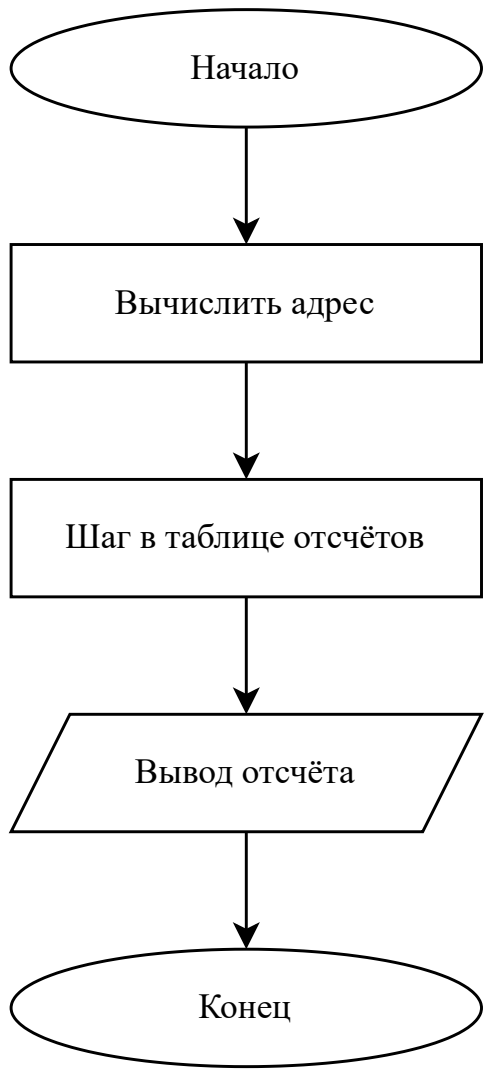
[picture p92: page 1]
Начало; Вычислить адрес; Вывод отсчёта; Конец

Шаг в таблице отсчётов
