lilbudek/vkr/отчет/tex-presentation/pictures/buttons.pdf

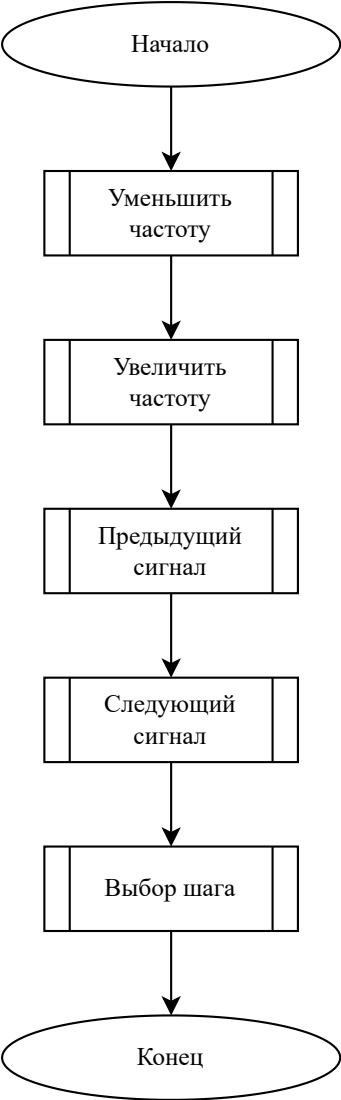
[picture p93: page 1]
Начало; Уменьшить частоту; Увеличить частоту; Предыдущий сигнал; Следующий сигнал; Выбор шага; Конец
