lilbudek/vkr/отчет/tex-presentation/pictures/dac.pdf

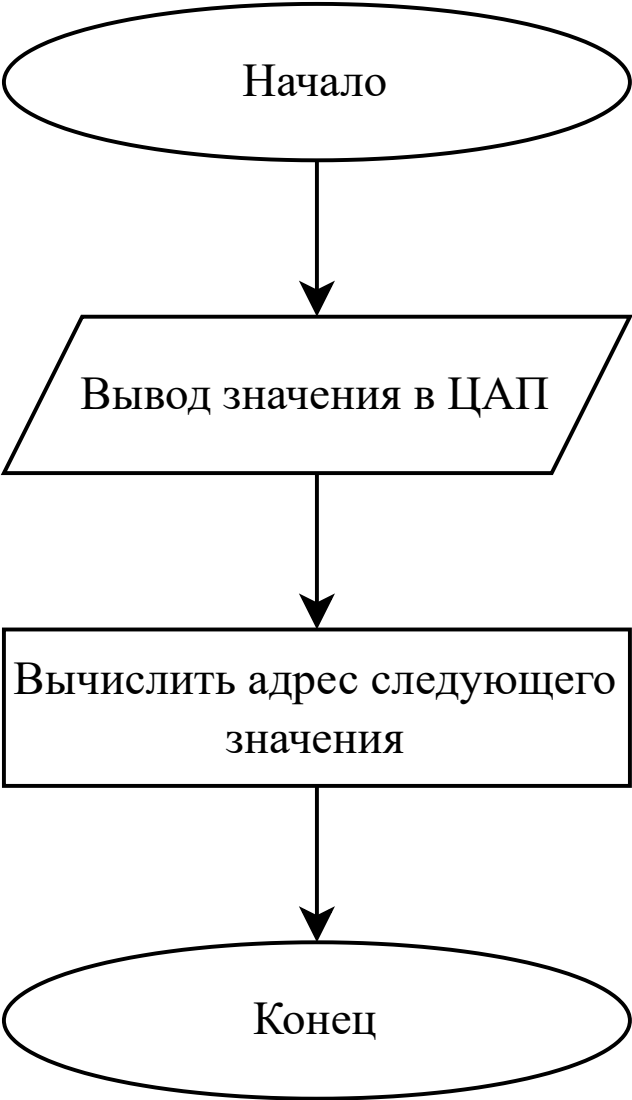
[picture p94: page 1]
Начало; значения; Конец

Вывод значения в ЦАП

Вычислить адрес следующего
