lilbudek/vkr/(list of files, drawings)

Other design files:
altium/gen/gen.PrjPcb
altium/gen/Schlib1.SchLib
altium/gen/Sheet1.SchDoc
