lilbudek/vkr/(commit log)

2024-04-19 нарисовал принципиалку
2024-04-19 выстроил +- содержание
2024-04-19 добавил разъем на принципиалке
2024-04-20 модель dds
2024-04-20 моделирование dds и методы генерации
2024-04-22 чуть-чуть изменил содержание
2024-04-23 презентация к конференции
2024-04-24 небольшие изменения в слайдах
2024-04-24 поправил цели и задачи
2024-04-26 написал заключение
2024-04-26 отредактировал введение
2024-04-27 поправил введение
2024-04-27 редактирование введения
2024-04-28 начал первую главу
2024-04-29 I. написал про виды сигналов
2024-04-30 I. написал про виды генераторов, начал про методы
2024-05-01 I. написал про методы. объём набран
2024-05-03 переоформил формулы
2024-05-03 I. переработал пункты про развитие и виды сигналов
2024-05-04 I. переработал первую главу, поменял ссылки
2024-05-04 I. мелкие правки
2024-05-06 I. глава принята
2024-05-07 II. dds (сослаться на схему), ide (добавить iar)
2024-05-07 схема электрическая принципиальная
    [Schlib1.SchLib, Sheet1.SchDoc, gen.PrjPcb]
2024-05-08 II. начал описание алгоритма
2024-05-14 II. сделал обзор МК
2024-05-15 II. дописал про алгоритмы. глава закончена
2024-05-16 II. внесены мелкие правки. глава принята
2024-05-18 III. начал третью главу
2024-05-19 III. написал про кнопки
2024-05-20 III. написал про макет
2024-05-20 мелкие правки
2024-05-21 III. тест кнопочек и дисплея
2024-05-22 измерения сигнала синуса 1 кГц и бпф
    [DS0001.CSV, samples.xlsx]
2024-05-22 III. осциллограммы для шагов и их погрешность
2024-05-23 III. убрал лишнее
2024-05-23 III. сделал от души
    наверное стоит заняться форматированием рисунков
2024-05-25 исправлены замечания по оформлению
2024-05-26 правки, презентация, доклад
2024-06-01 обзор аналогов, более подробный алгоритм
2024-06-02 реферат, источники
2024-06-03 анализ сигнала в octave
    построен идеальный сигнал и посчитано бпф. обнаружено смещение по частоте и фазе
    [data.csv, ff.CSV, fft.CSV, samples.xlsx]
2024-06-04 III. анализ сигнала
    [fft.CSV]
2024-06-05 нормоконтроль
2024-06-19 доклад и презентация
2024-06-20 замечания по выступлению
2024-06-23 номера слайдов
